Lymes/RF-FE/adc_adapter.asc

C1: cap; 100nF
C2: cap; 10µF
R1: res; 50
R2: res; 10k
R3: res; 10k
R4: res; 100
R5: res; 10k
V1: voltage; 3.3V
V2: voltage; SINE(0 0.1 7.1Meg)
Named nets: ADC_IN, VCC, 0, LNA_OUT
.tran 10u
