Lymes/RF-FE/(commit log)

2026-08-21 Add ADC adapter circuit: schematic, LTSpice sim, .gitignore for LTSpice outputs
2026-08-21 Fix R2/R5 descriptions in ADC adapter table
2026-08-22 Add ADC adapter measurements, undersampling architecture and 40m performance estimates
